IsaiDG/Dual-Clipping-Guitar-Overdrive-Pedal/images/3D_PCB_Rendering.png

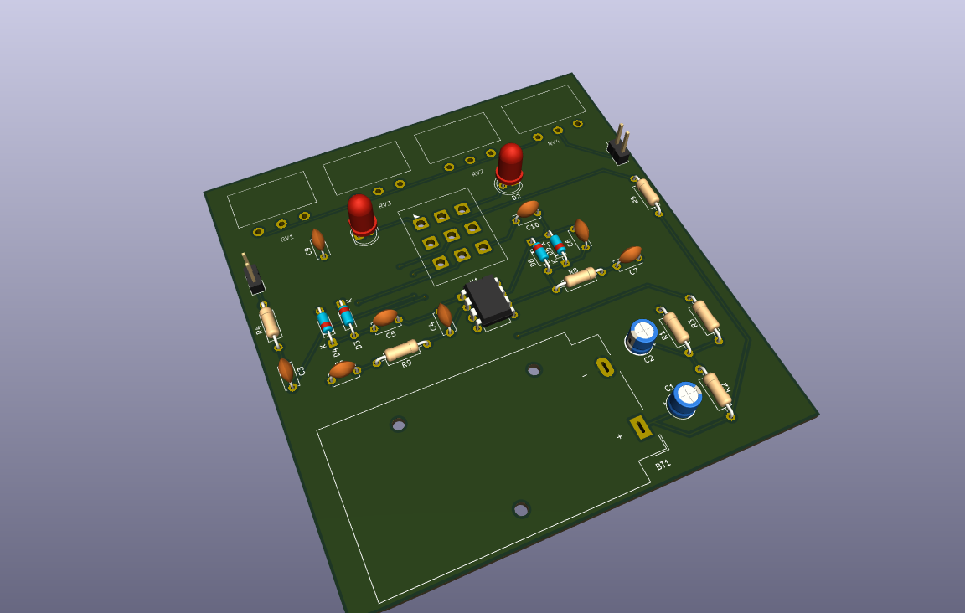
images/3D_PCB_Rendering.png
