IsaiDG/Dual-Clipping-Guitar-Overdrive-Pedal/images/Breadboard_Pedal.png

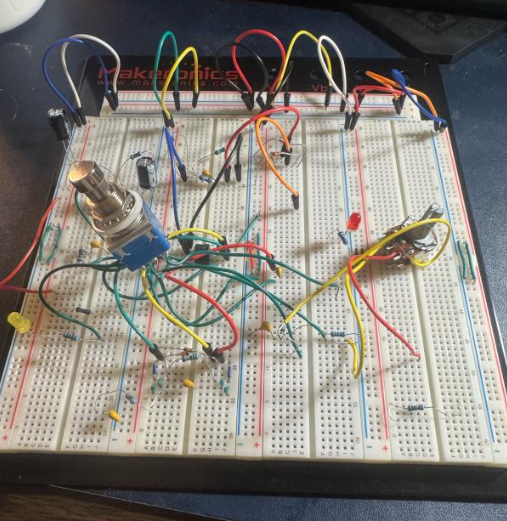
images/Breadboard_Pedal.png
