IsaiDG/Dual-Clipping-Guitar-Overdrive-Pedal/images/Hard_Clipping_Half_Tone_Frequency_Response.png

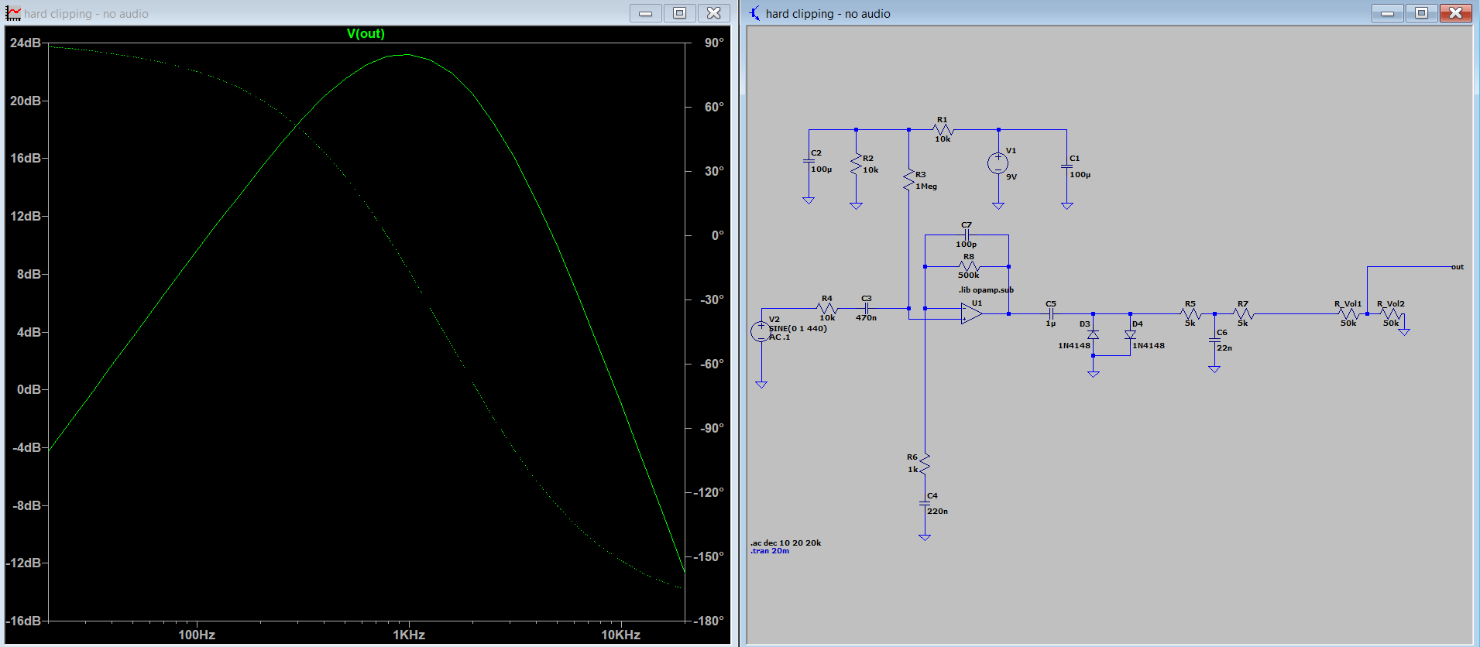
images/Hard_Clipping_Half_Tone_Frequency_Response.png
