IsaiDG/Dual-Clipping-Guitar-Overdrive-Pedal/images/Hard_Clipping_Max_Gain_Transient_Response.png

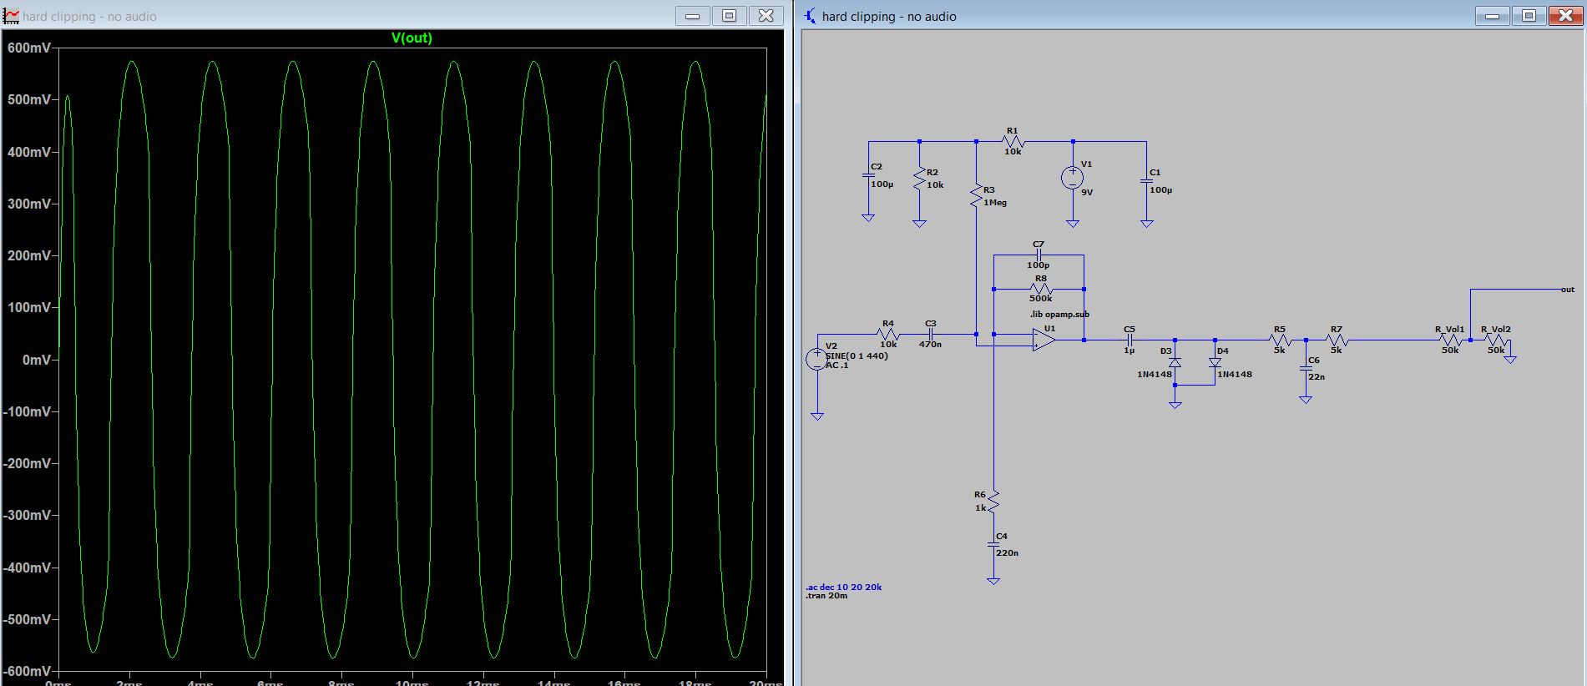
images/Hard_Clipping_Max_Gain_Transient_Response.png
