IsaiDG/Dual-Clipping-Guitar-Overdrive-Pedal/images/PCB_Layout.png

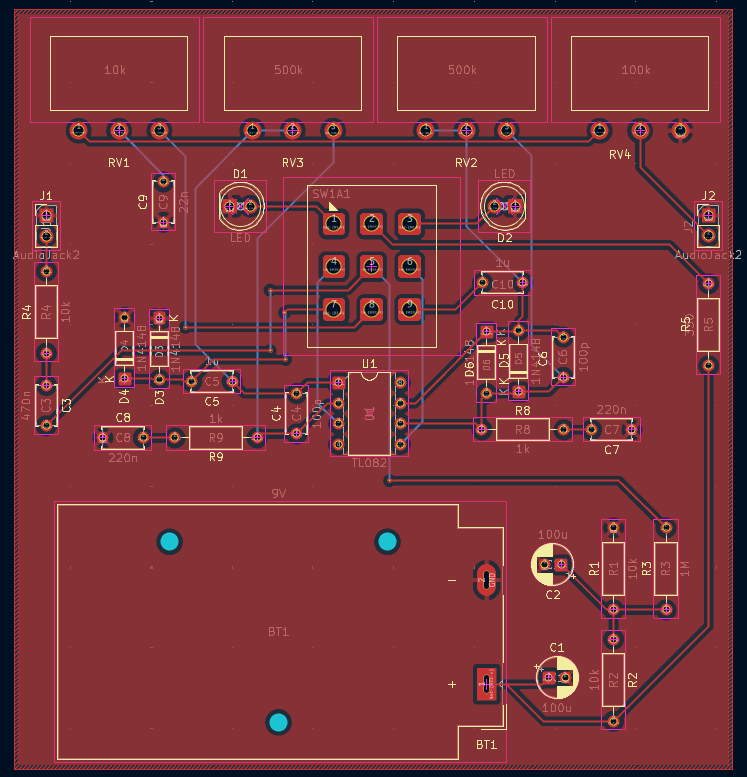
images/PCB_Layout.png
