IsaiDG/Dual-Clipping-Guitar-Overdrive-Pedal/images/Soft_Clipping_Half_Tone_Frequency_Response.png

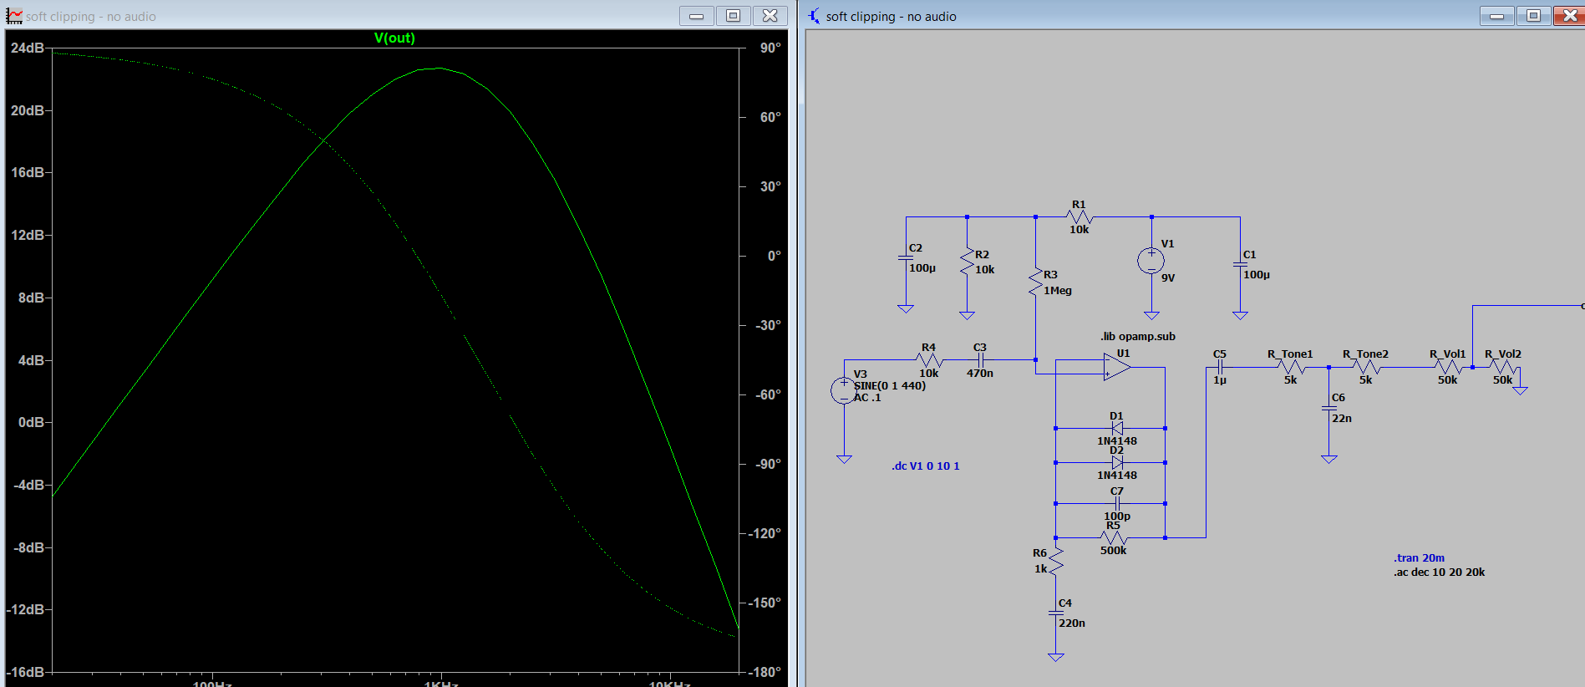
images/Soft_Clipping_Half_Tone_Frequency_Response.png
