IsaiDG/Dual-Clipping-Guitar-Overdrive-Pedal/images/Soft_Clipping_Max_Gain_Transient_Response.png

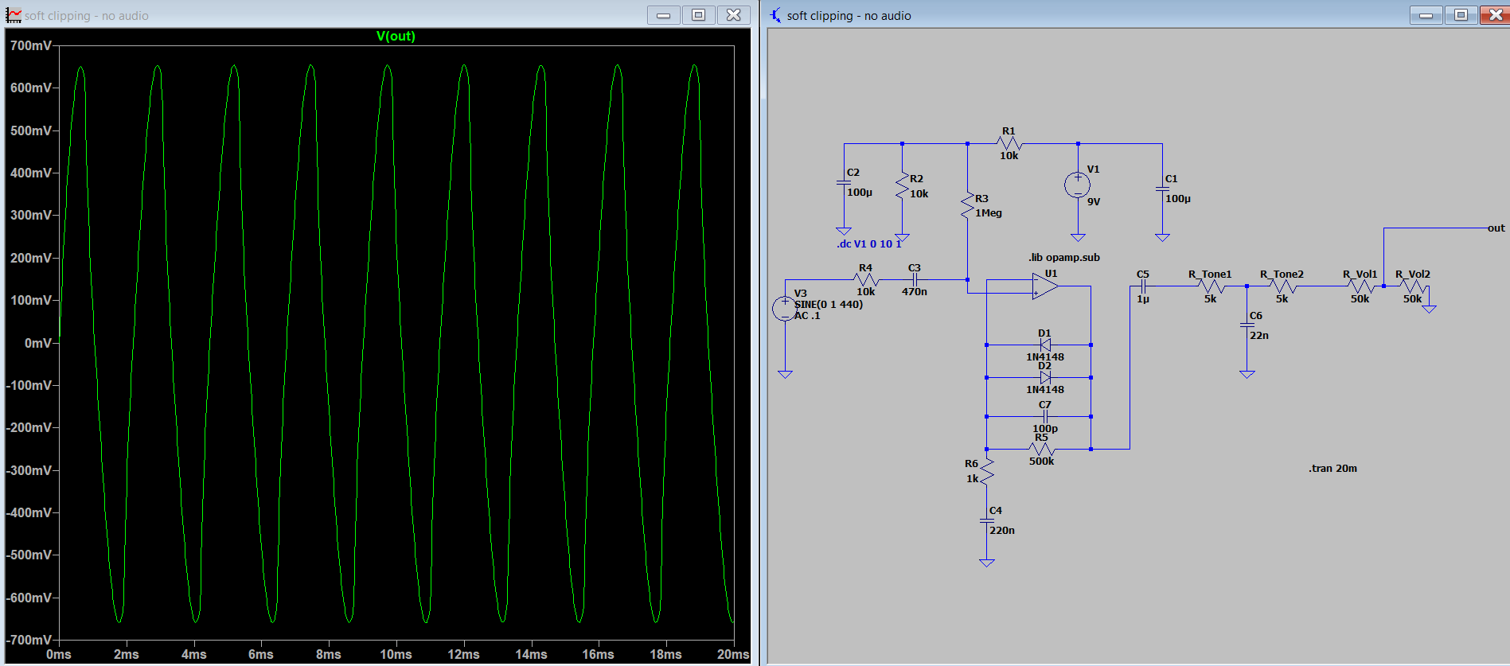
images/Soft_Clipping_Max_Gain_Transient_Response.png
