IsaiDG/Dual-Clipping-Guitar-Overdrive-Pedal/Delevopment/Components_and_Values.md

# DC Power Supply

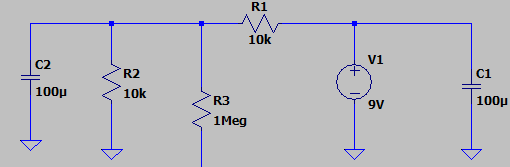
[picture p9: images/DCBias.png]
Power Supply
