IsaiDG/Dual-Clipping-Guitar-Overdrive-Pedal/Hardware/Pedal_PCB.kicad_pcb

## KiCad design Hardware/Pedal_PCB.kicad_pcb (2026-10-12)

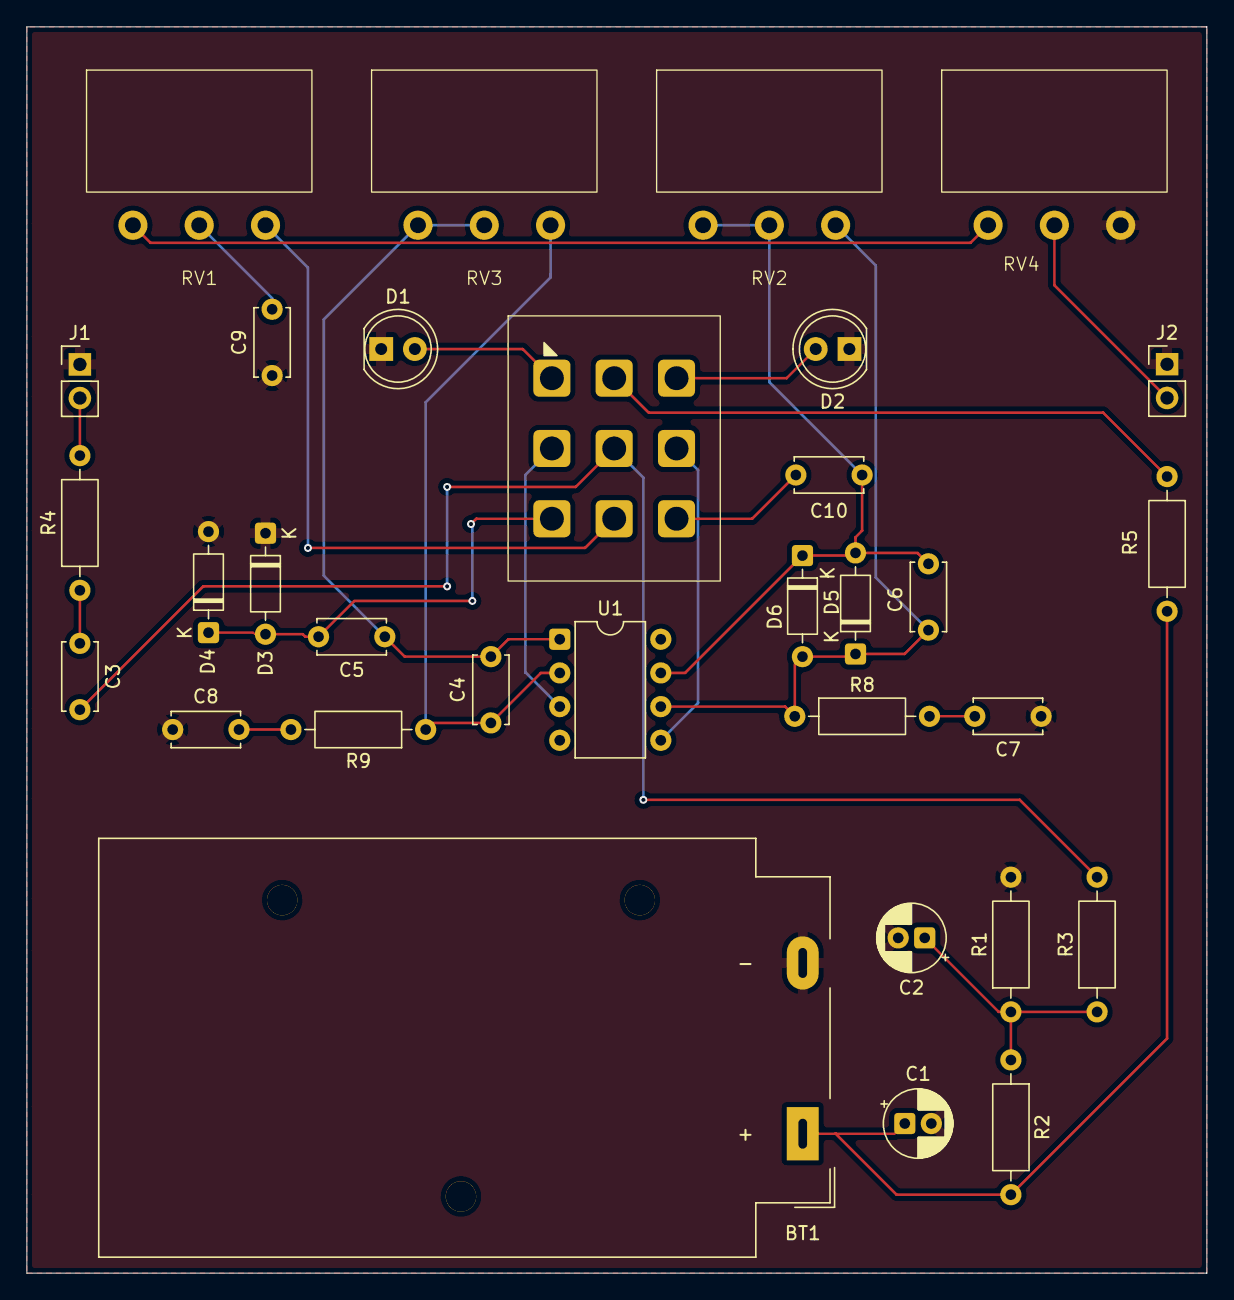
[picture p10: board Pedal_PCB.kicad_pcb from above]

Board: 4 copper layers, 89.0 x 94.0 mm, 32 parts (0 on the bottom side), 23 nets.

Parts:
BT1: 9V; BatteryHolder_MPD_BA9VPC_1xPP3
C1, C2: 100u; CP_Radial_D5.0mm_P2.00mm
C3: 470n; C_Disc_D5.0mm_W2.5mm_P5.00mm
C4, C6: 100p; C_Disc_D5.0mm_W2.5mm_P5.00mm
C5, C10: 1u; C_Disc_D5.0mm_W2.5mm_P5.00mm
C7, C8: 220n; C_Disc_D5.0mm_W2.5mm_P5.00mm
C9: 22n; C_Disc_D5.0mm_W2.5mm_P5.00mm
D1, D2: LED; LED_D5.0mm
D3, D4, D5, D6: 1N4148; D_DO-35_SOD27_P7.62mm_Horizontal
J1, J2: AudioJack2; PinHeader_1x02_P2.54mm_Vertical
R1, R2, R4: 10k; R_Axial_DIN0207_L6.3mm_D2.5mm_P10.16mm_Horizontal
R3: 1M; R_Axial_DIN0207_L6.3mm_D2.5mm_P10.16mm_Horizontal
R5: 330; R_Axial_DIN0207_L6.3mm_D2.5mm_P10.16mm_Horizontal
R8, R9: 1k; R_Axial_DIN0207_L6.3mm_D2.5mm_P10.16mm_Horizontal
RV1: 10k; pots
RV2, RV3: 500k; pots
RV4: 100k; pots
SW1A1: SW_SPDT; 3PDT_FootPrint
U1: TL082; DIP-8_W7.62mm

Connections:
GND: BT1.2 (-), C1.2, C2.2, C7.1, C8.1, C9.1, D1.1 (K), D2.1 (K), D3.1 (K), D4.2 (A), J1.1, J2.1, R1.2, RV4.3
unnamed: BT1.1 (+), C1.1, R2.2, R5.2
unnamed: C2.1, R1.1, R2.1, R3.1
unnamed: C3.1, R4.1
unnamed: C4.2, C5.1, RV3.1, RV3.2, U1.1
unnamed: C7.2, R8.2
unnamed: C8.2, R9.2
unnamed: C9.2, RV1.2
unnamed: D1.2 (A), SW1A1.1 (A)
unnamed: D2.2 (A), SW1A1.3 (C)
unnamed: C5.2, D3.2 (A), D4.1 (K), SW1A1.7
unnamed: C6.2, C10.1, D5.2 (A), D6.1 (K), RV2.1, RV2.2, U1.7
unnamed: C6.1, D5.1 (K), D6.2 (A), R8.1, RV2.3, U1.6 (-)
unnamed: J1.2, R4.2
unnamed: J2.2, RV4.2
unnamed: RV1.1, RV4.1
unnamed: R5.1, SW1A1.2 (B)
unnamed: SW1A1.4, U1.3 (+)
unnamed: C3.2, R3.2, SW1A1.5
unnamed: SW1A1.6, U1.5 (+)
unnamed: RV1.3, SW1A1.8
unnamed: C10.2, SW1A1.9
unnamed: C4.1, R9.1, RV3.3, U1.2 (-)
